Franciscoj04/ARQUI2_PROYECTO_G4/(commit log)

2026-08-29 actualizacion de documentacion
2026-08-29 cambios de documenatcion
